AouissiBrahim/SG13CMOS5L_LPVSV_Chipalooza_2/Docs/LPVSV_DRC.png

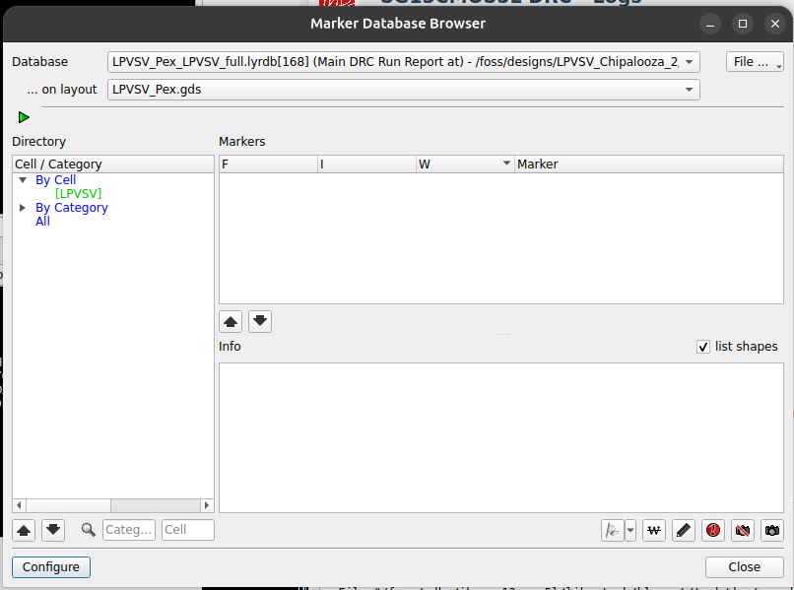
Docs/LPVSV_DRC.png
