AouissiBrahim/SG13CMOS5L_LPVSV_Chipalooza_2/Docs/LPVSV_LVS.png

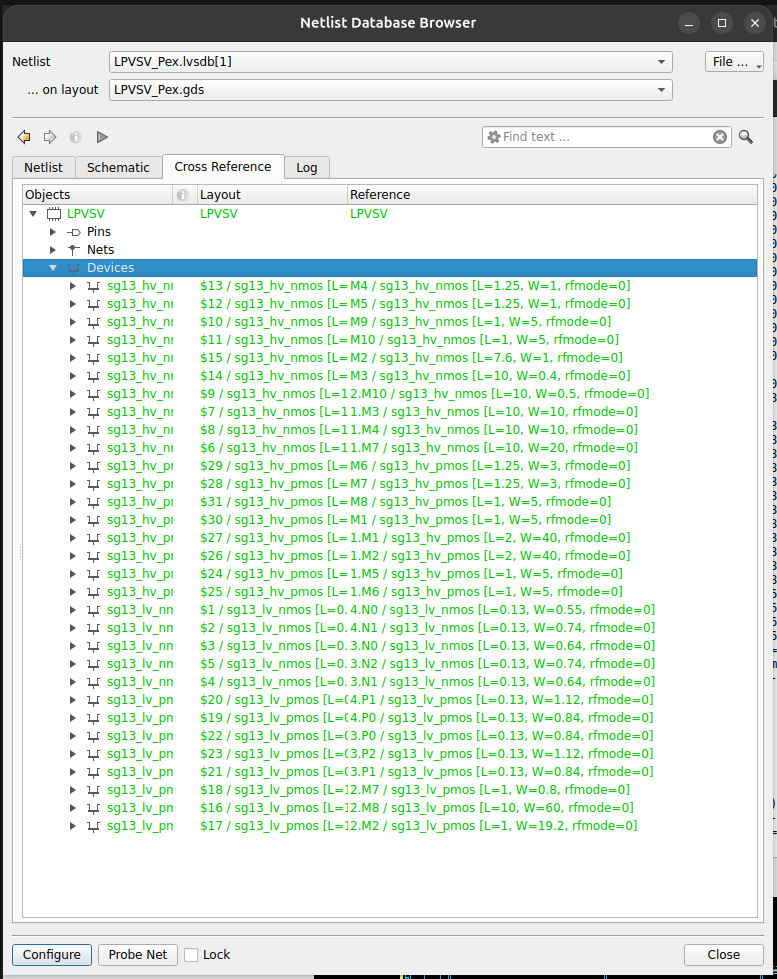
Docs/LPVSV_LVS.png
