AouissiBrahim/SG13CMOS5L_LPVSV_Chipalooza_2/Docs/LPVSV_SLOT_17.png

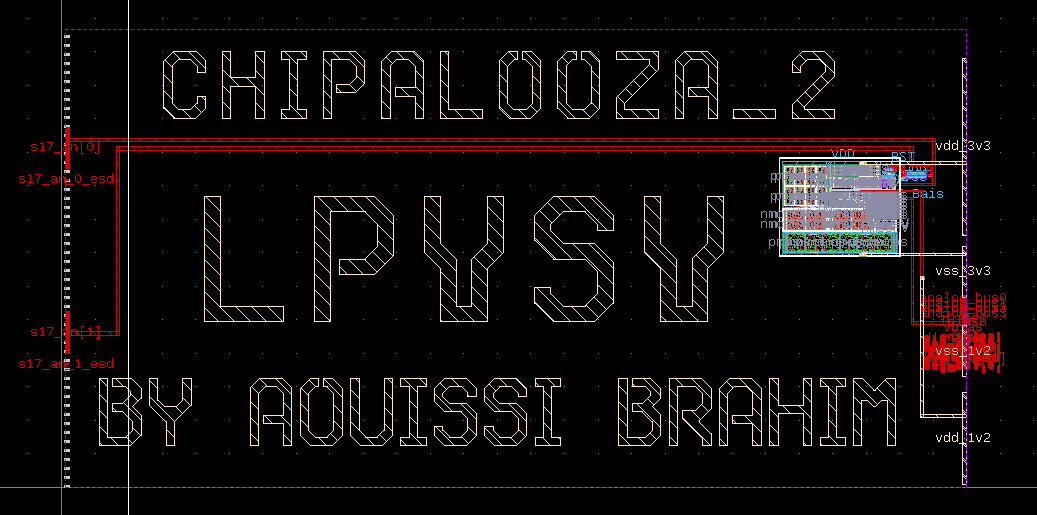
Docs/LPVSV_SLOT_17.png
