AouissiBrahim/SG13CMOS5L_LPVSV_Chipalooza_2/Docs/sg13cmos5l_AouissiBrahim_LPVSV_POR_DRC.png

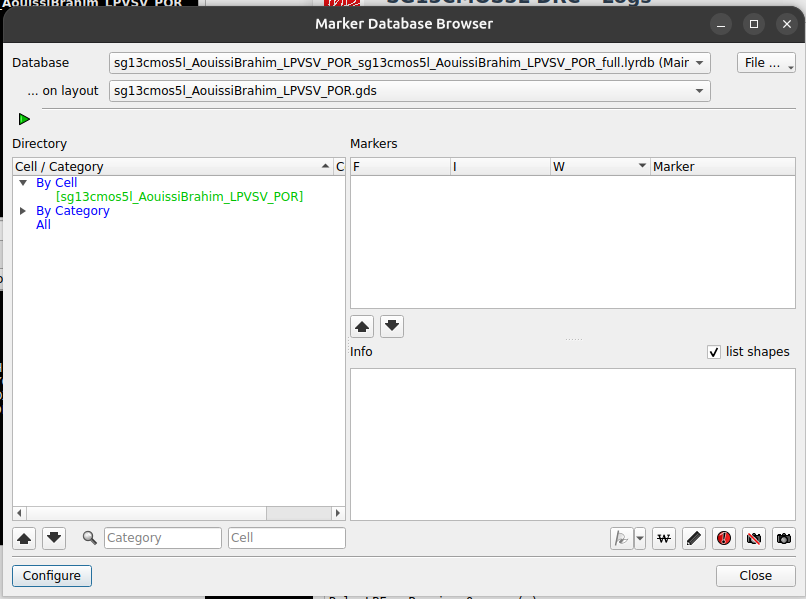
Docs/sg13cmos5l_AouissiBrahim_LPVSV_POR_DRC.png
