AouissiBrahim/SG13CMOS5L_LPVSV_Chipalooza_2/(commit log)

2026-09-26 Update LPVSV design
    [Buffer.sch, Comp_2Stage.sch, DC_TB.sch, DC_TB_MC.sch, DC_Temp_TB.sch, Delay.sch, Divider.sch, LPVSV.sch]
2026-10-07 Update LPVSV
    [DC_TB.sch, LPVSV.sch, Tran_TB.sch]
2026-10-22 Update slot 17 layout and DRC results
